Hypertera/Robot-Planar-2GDL/README.md

# Robot-Planar-2GDL

Este es un repositorio para construir tu propio robot planar de dos grados de libertad. Aqui encontrarás todos los archivos necesarios para crear tu robot. La guia paso a paso la encontraras en mi canal de YouTube https://www.youtube.com/@Hypertera.
