Hypertera/Robot-Planar-2GDL/Recursos/BrazoPlanar.png

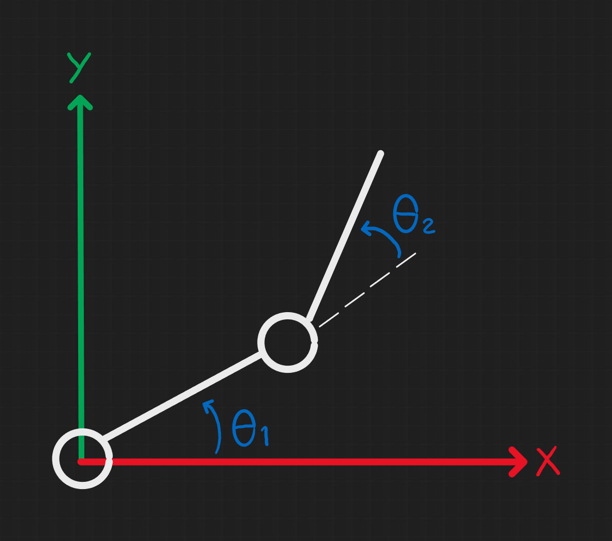
Recursos/BrazoPlanar.png
