Hypertera/Robot-Planar-2GDL/Recursos/Cinemática.png

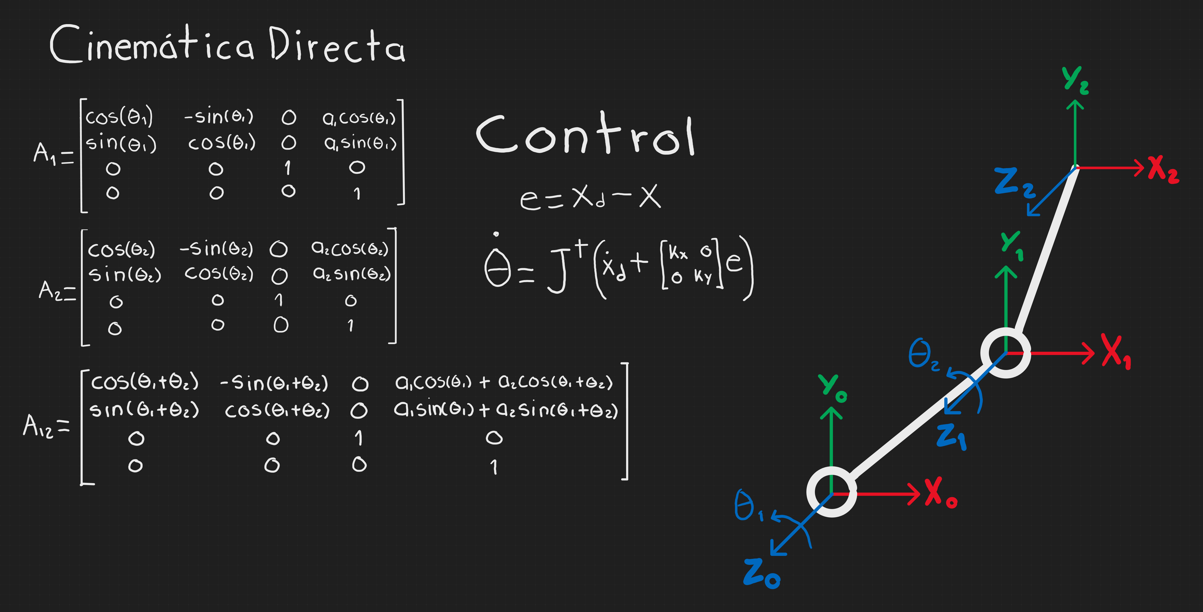
Recursos/Cinemática.png
