Hypertera/Robot-Planar-2GDL/Archivos3D/Base/Cruz.step

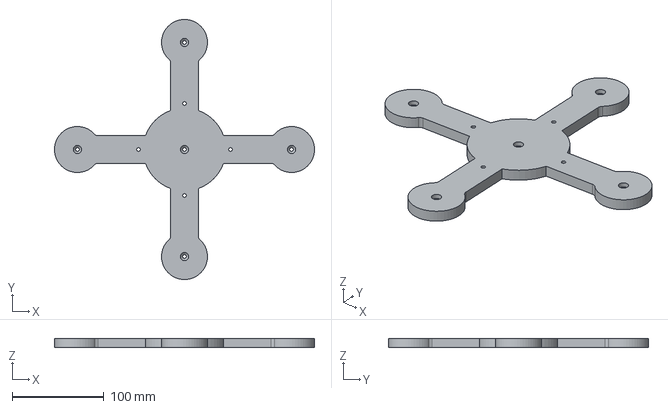
[picture p18: CAD file, 2026-08-15]
Archivos3D/Base/Cruz.step
282.7 x 282.7 x 10.0 mm
