Hypertera/Robot-Planar-2GDL/Archivos3D/Cubiertas/Cubierta2.step

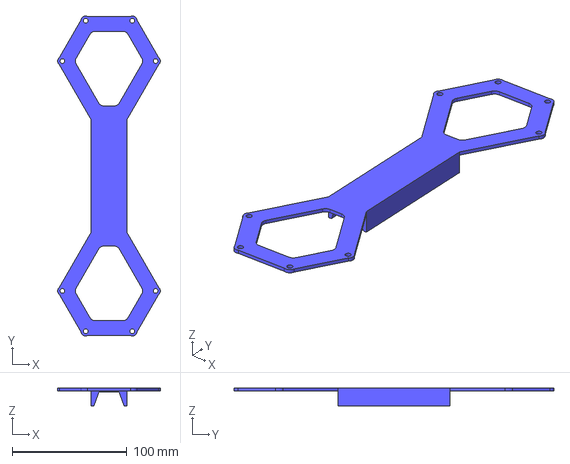
[picture p19: CAD file, 2026-08-15]
Archivos3D/Cubiertas/Cubierta2.step
89.4 x 278.5 x 15.4 mm
