Hypertera/Robot-Planar-2GDL/Archivos3D/Engranajes/Sol.step

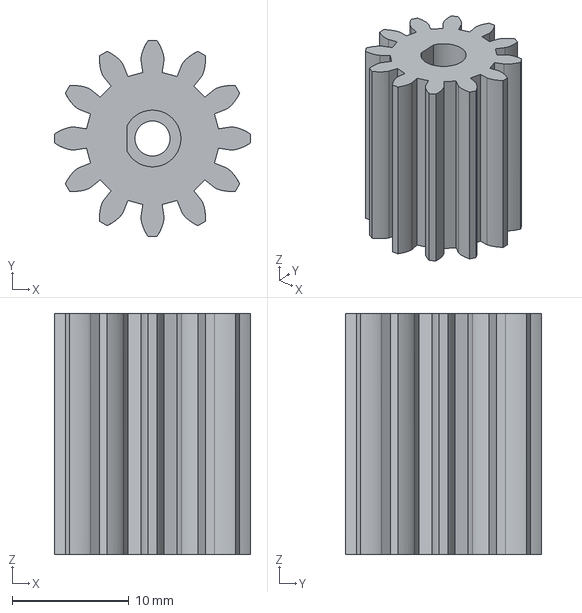
[picture p20: CAD file, 2026-08-15]
Archivos3D/Engranajes/Sol.step
16.8 x 16.8 x 20.6 mm
