Hypertera/Robot-Planar-2GDL/Archivos3D/Eslabones/Eslabn1.step

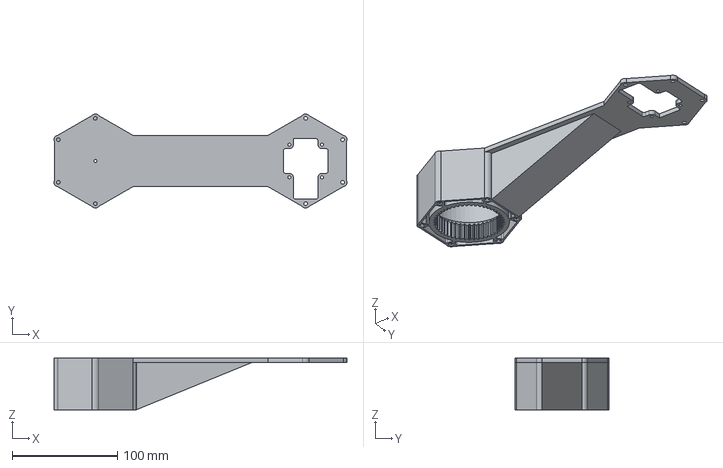
[picture p21: CAD file, 2026-08-15]
Archivos3D/Eslabones/Eslabn1.step
278.5 x 89.4 x 49.0 mm
