Hypertera/Robot-Planar-2GDL/Archivos3D/MarcoEncoder/MarcoEncod.step

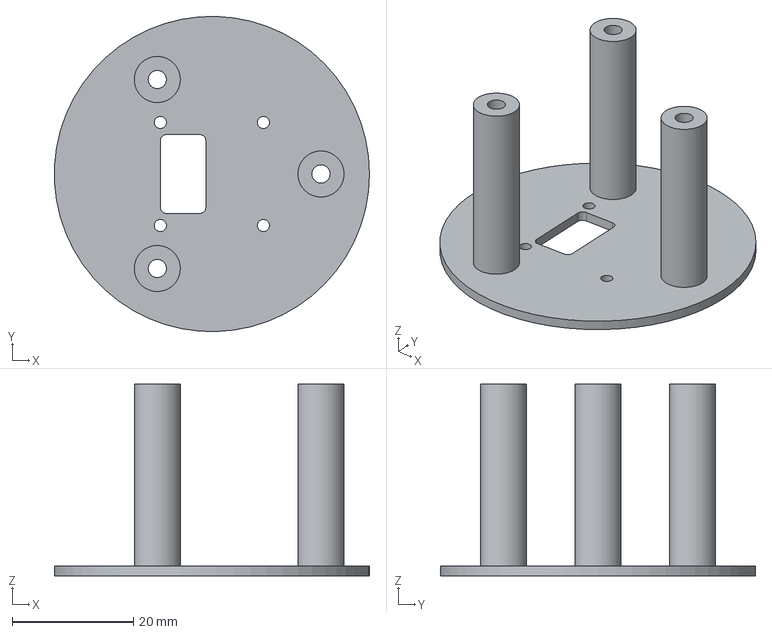
[picture p22: CAD file, 2026-08-15]
Archivos3D/MarcoEncoder/MarcoEncod.step
52.0 x 52.0 x 31.6 mm
