Hypertera/Robot-Planar-2GDL/Archivos3D/MarcoEngranajes/Separador.step

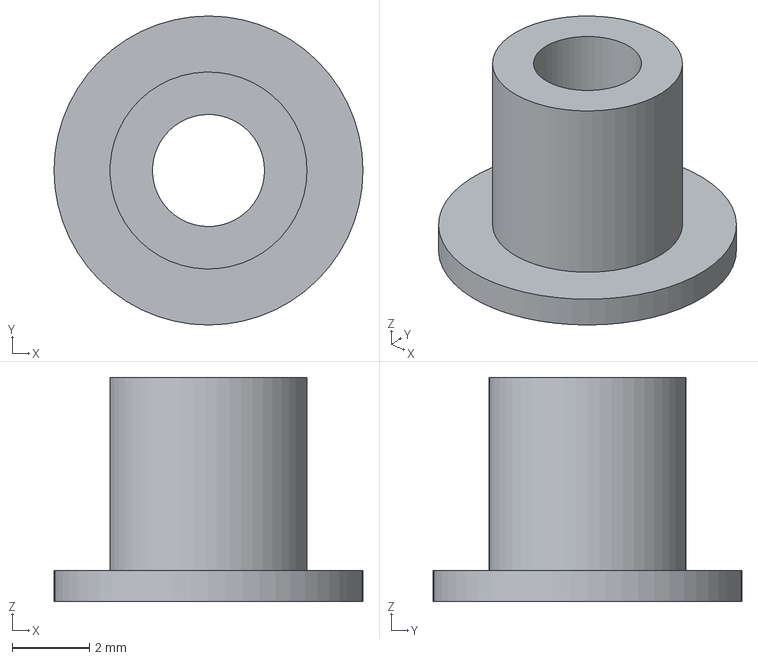
[picture p23: CAD file, 2026-08-15]
Archivos3D/MarcoEngranajes/Separador.step
8.00 x 8.00 x 5.80 mm
