Hypertera/Robot-Planar-2GDL/Archivos3D/Pruebas/CarcSen.step

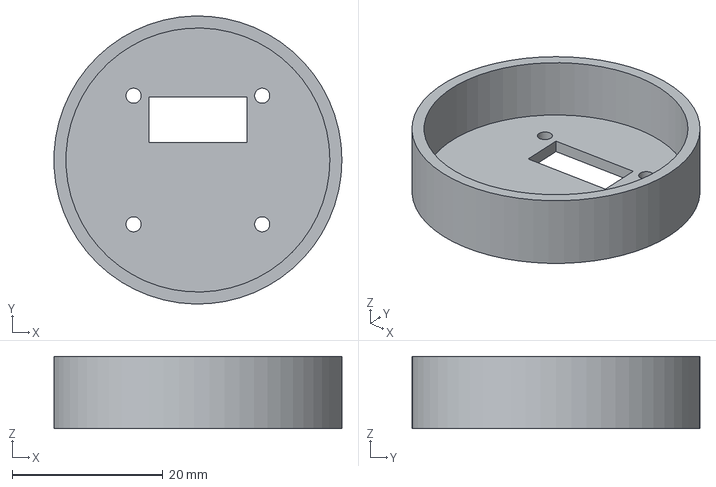
[picture p24: CAD file, 2026-06-08]
Archivos3D/Pruebas/CarcSen.step
38.2 x 38.2 x 9.60 mm
