Hypertera/Robot-Planar-2GDL/Archivos3D/Base/Base.step

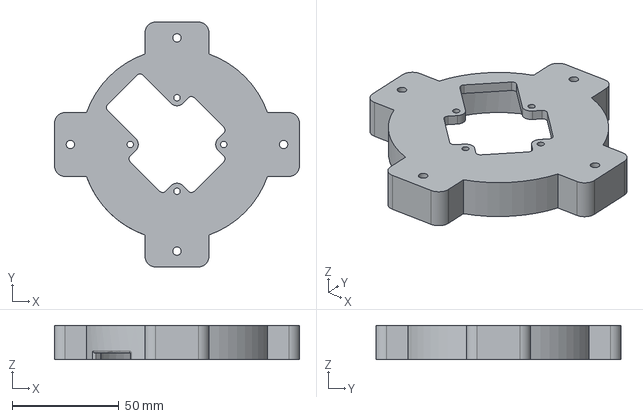
[picture p25: CAD file, 2026-08-15]
Archivos3D/Base/Base.step
114.9 x 114.9 x 16.0 mm
