Hypertera/Robot-Planar-2GDL/Archivos3D/Cubiertas/Cubierta.step

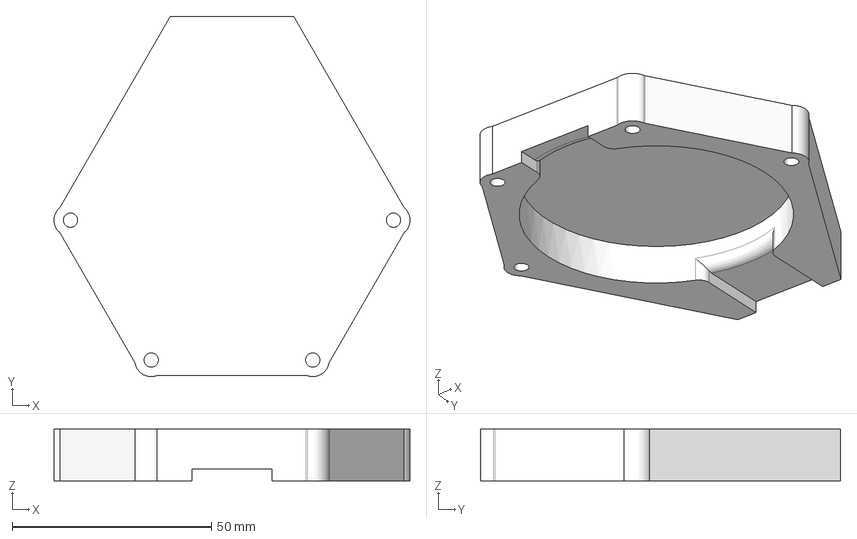
[picture p26: CAD file, 2026-08-15]
Archivos3D/Cubiertas/Cubierta.step
89.4 x 90.4 x 13.0 mm
