Hypertera/Robot-Planar-2GDL/Archivos3D/Engranajes/Planet.step

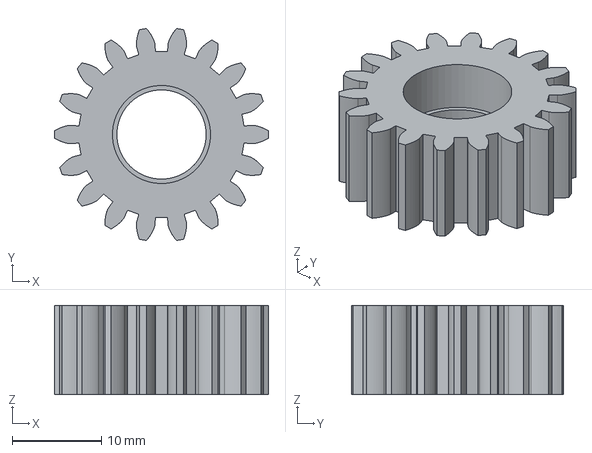
[picture p27: CAD file, 2026-08-15]
Archivos3D/Engranajes/Planet.step
24.0 x 23.8 x 10.0 mm
