Hypertera/Robot-Planar-2GDL/Archivos3D/Eslabones/BaseEslbn.step

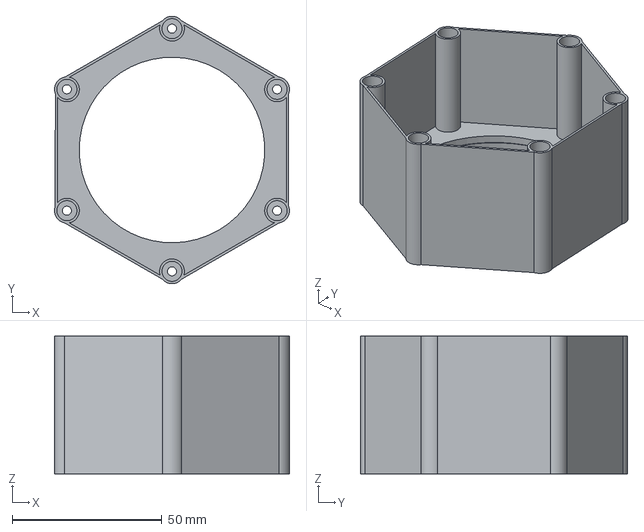
[picture p28: CAD file, 2026-08-15]
Archivos3D/Eslabones/BaseEslbn.step
78.5 x 89.4 x 46.0 mm
