Hypertera/Robot-Planar-2GDL/Archivos3D/MarcoEngranajes/MarcoEng.step

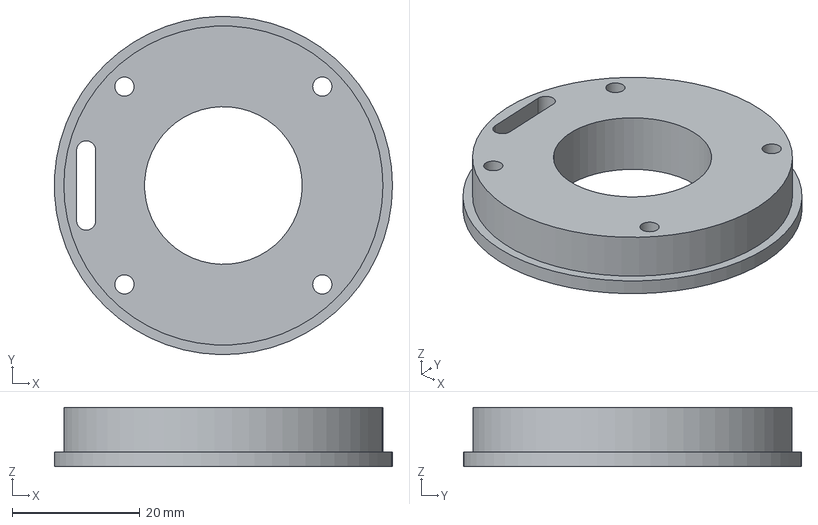
[picture p29: CAD file, 2026-08-15]
Archivos3D/MarcoEngranajes/MarcoEng.step
53.0 x 53.0 x 9.30 mm
