Hypertera/Robot-Planar-2GDL/Archivos3D/Pruebas/TapaSen.step

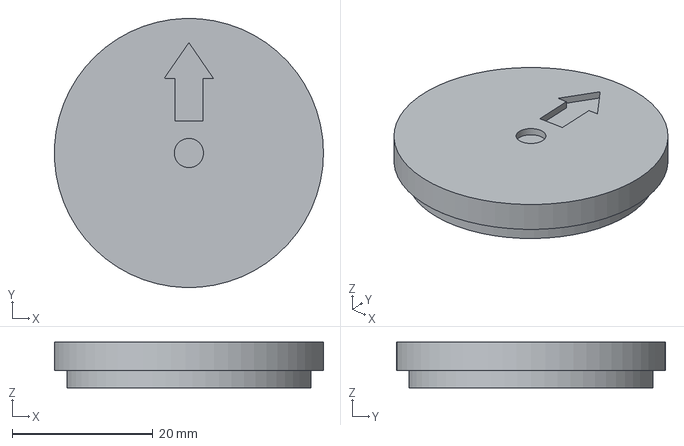
[picture p30: CAD file, 2026-06-08]
Archivos3D/Pruebas/TapaSen.step
38.2 x 38.2 x 6.50 mm
