Hypertera/Robot-Planar-2GDL/Archivos3D/Eslabones/Eslabn2.step

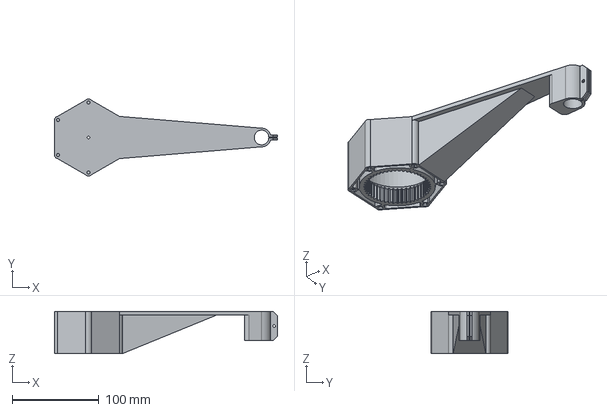
[picture p31: CAD file, 2026-08-15]
Archivos3D/Eslabones/Eslabn2.step
257.6 x 89.4 x 49.0 mm
